Lee-Kevin/20.IoTRouter/images/5.png

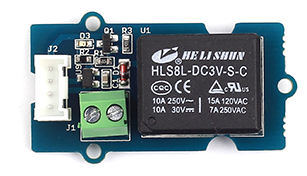
images/5.png
