Lee-Kevin/20.IoTRouter/images/6.png

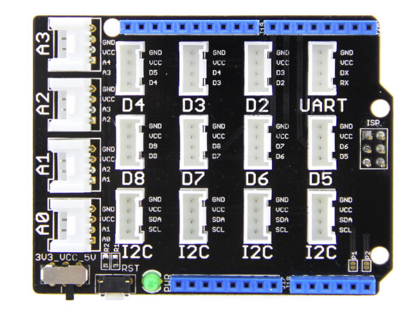
images/6.png
