Lee-Kevin/20.IoTRouter/images/8.png

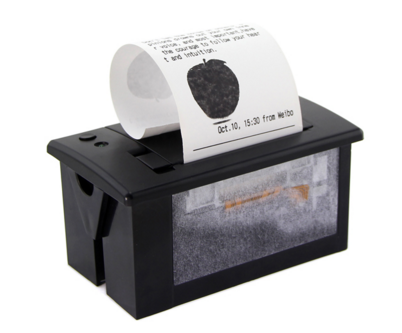
images/8.png
