Lee-Kevin/20.IoTRouter/images/13.png

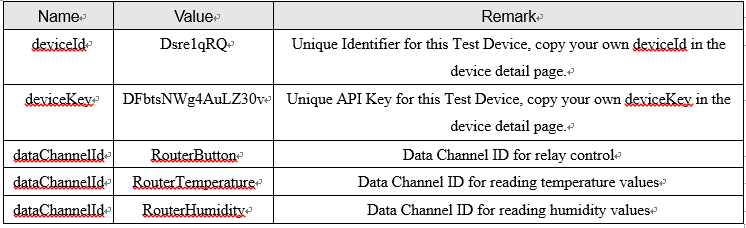
images/13.png
