Lee-Kevin/20.IoTRouter/images/15.png

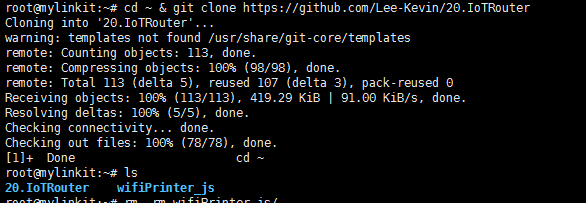
images/15.png
