Lee-Kevin/20.IoTRouter/images/17.png

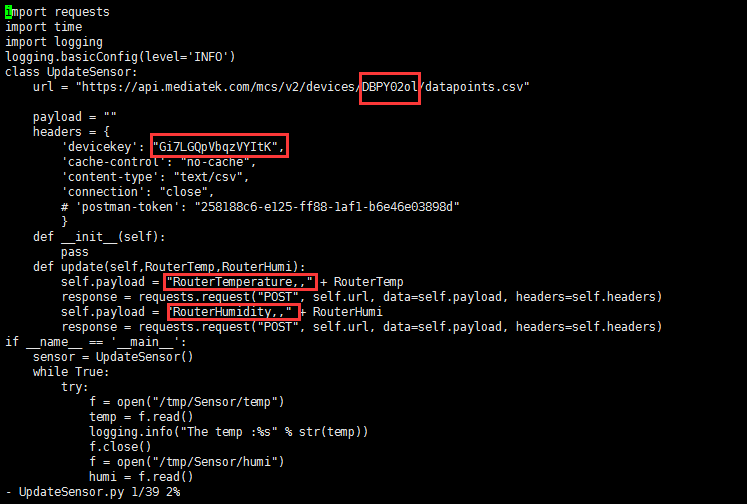
images/17.png
