Lee-Kevin/20.IoTRouter/images/18.png

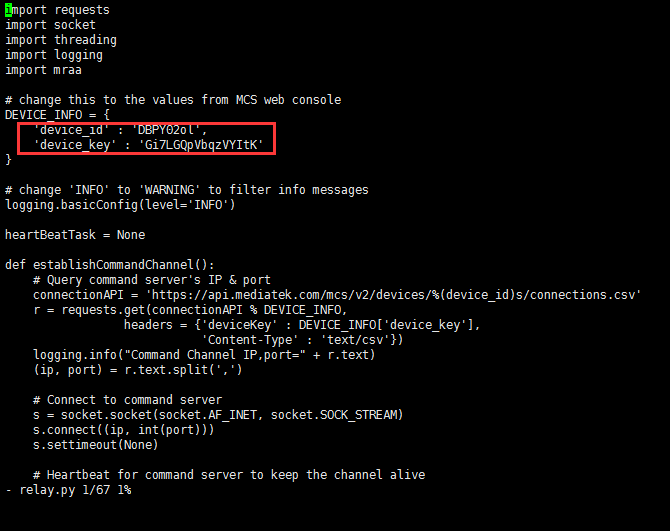
images/18.png
