Lee-Kevin/20.IoTRouter/images/21.jpg

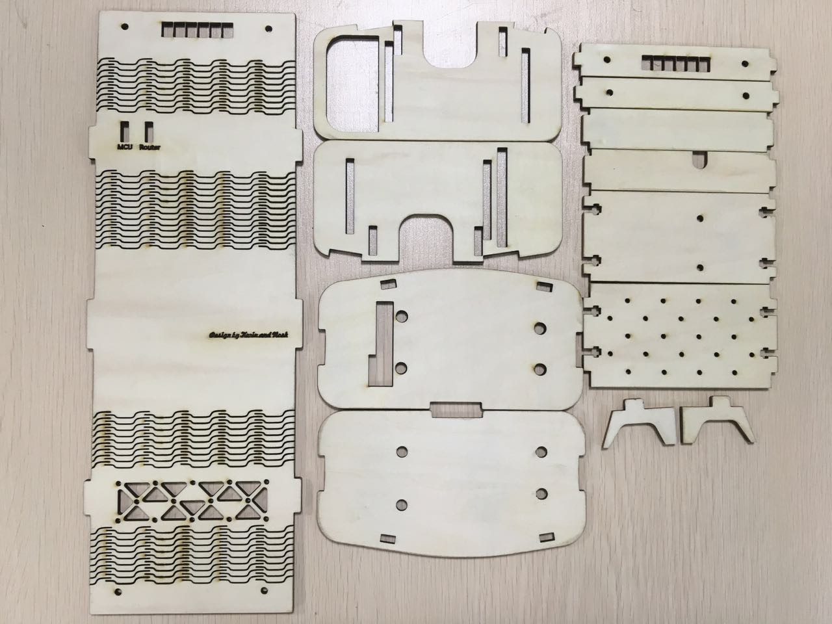
images/21.jpg
