Lee-Kevin/20.IoTRouter/images/22.png

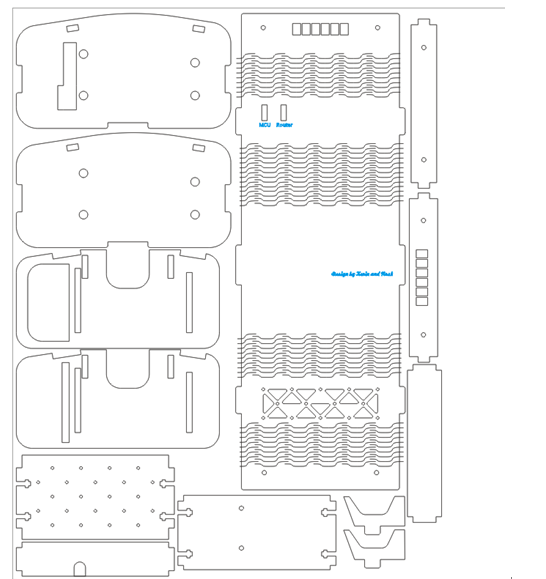
images/22.png
