Lee-Kevin/20.IoTRouter/images/23.png

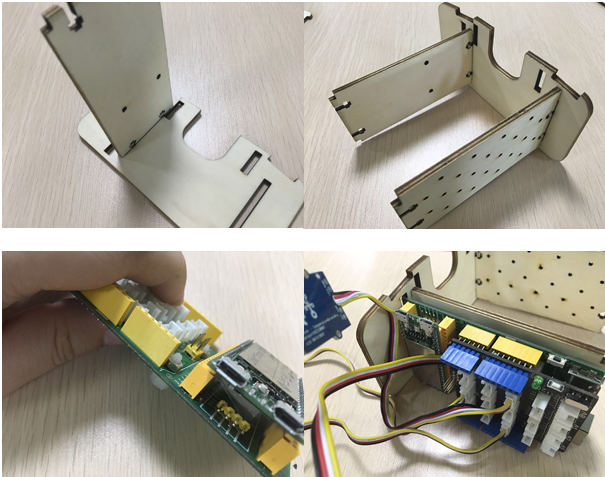
images/23.png
