Lee-Kevin/20.IoTRouter/images/24.png

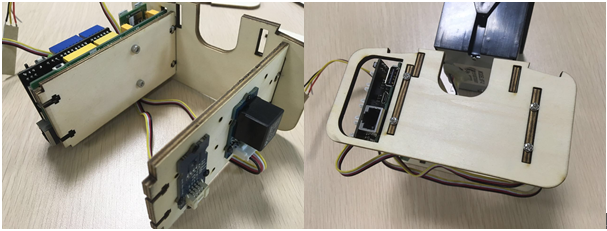
images/24.png
