Lee-Kevin/20.IoTRouter/images/25.jpg

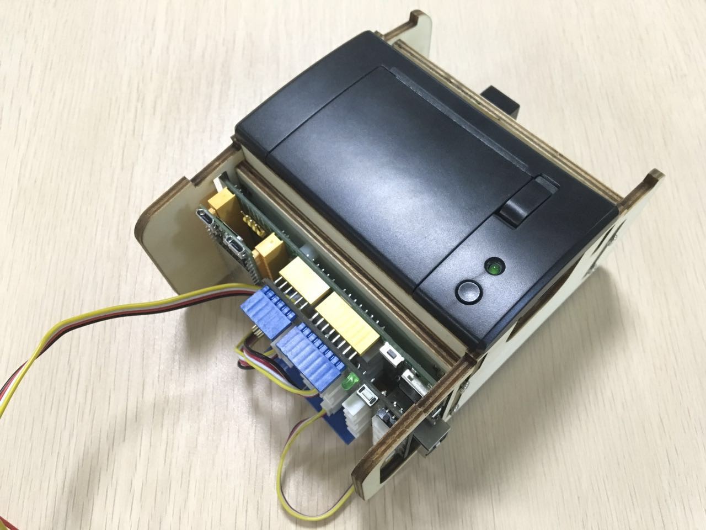
images/25.jpg
