Lee-Kevin/20.IoTRouter/images/26.png

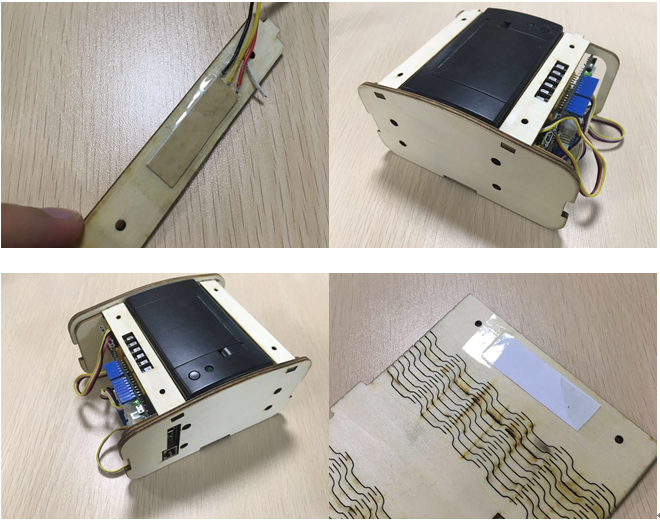
images/26.png
