Lee-Kevin/20.IoTRouter/images/27.png

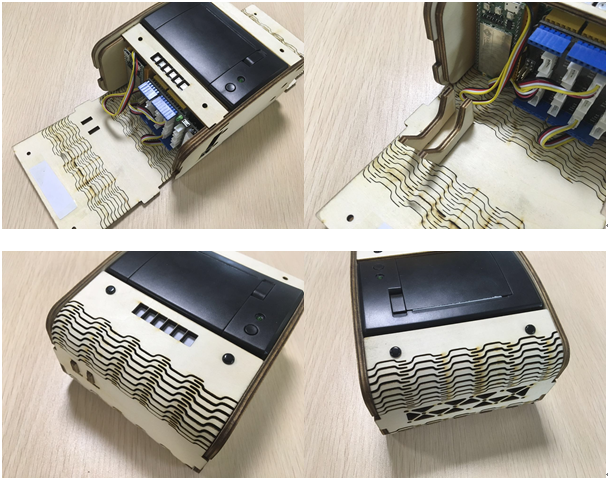
images/27.png
