Lee-Kevin/20.IoTRouter/images/28.jpg

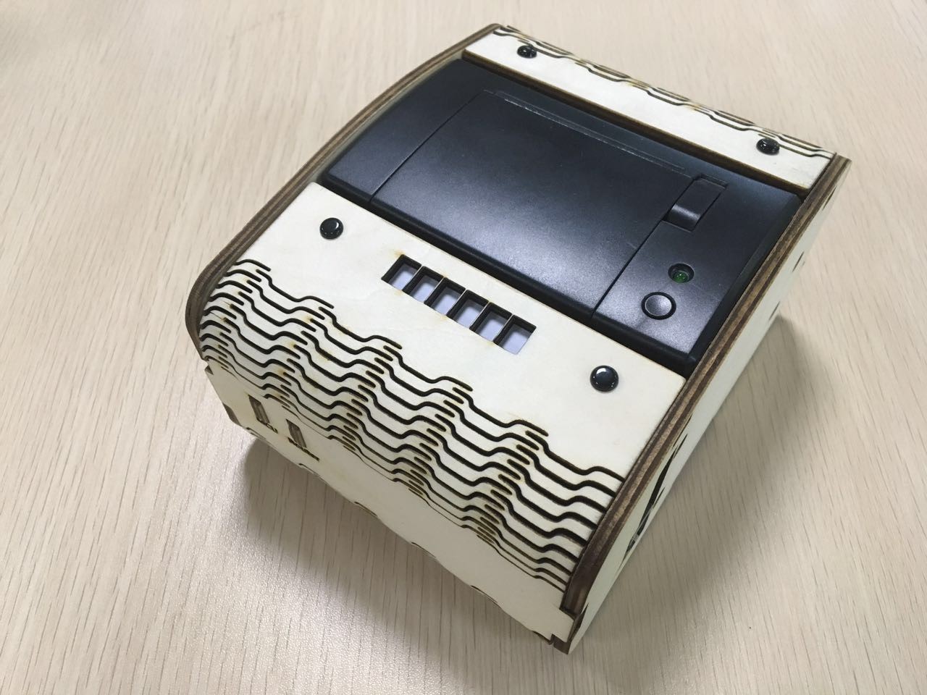
images/28.jpg
