Lee-Kevin/20.IoTRouter/images/29.jpg

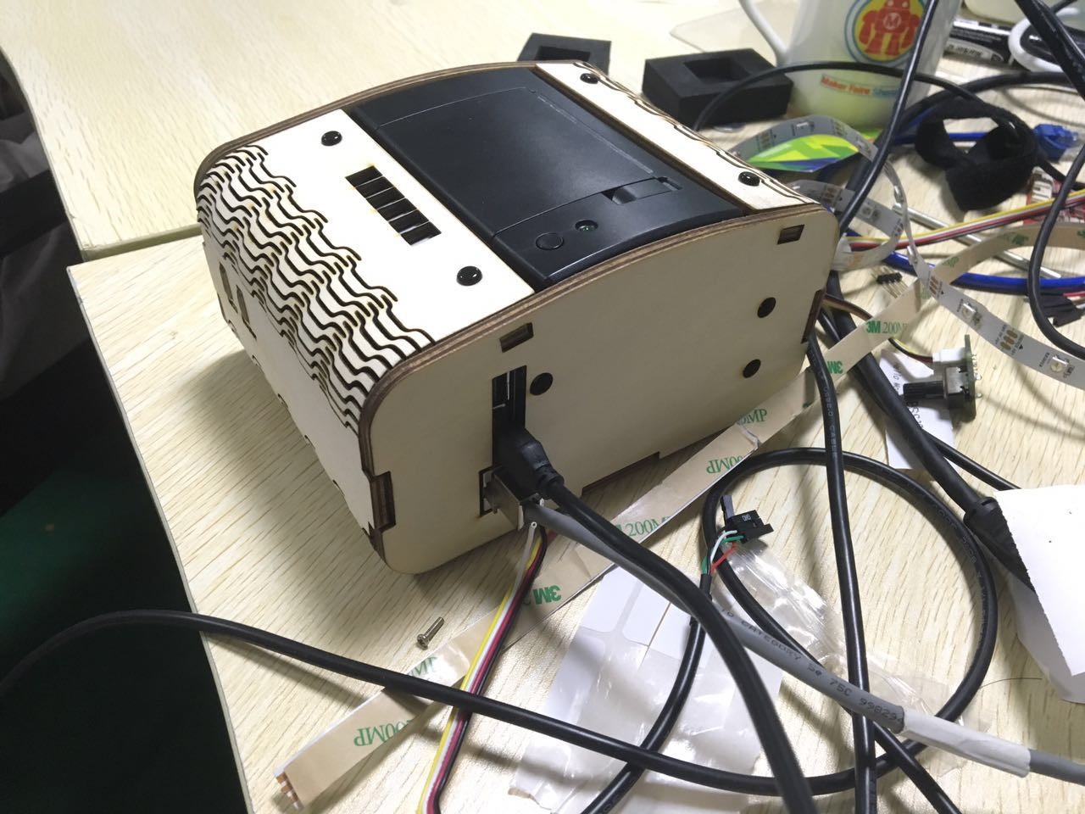
images/29.jpg
