Lee-Kevin/20.IoTRouter/images/31.jpg

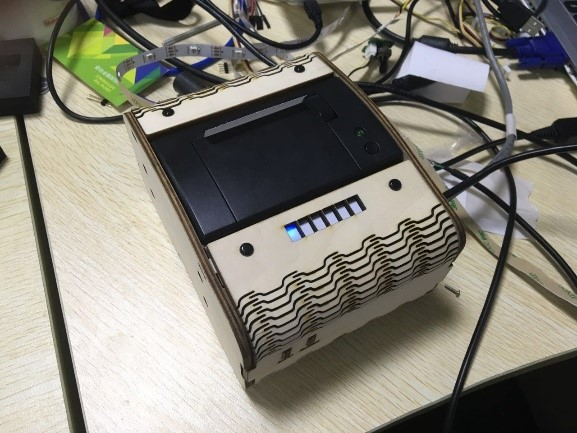
images/31.jpg
