Lee-Kevin/20.IoTRouter/images/32.png

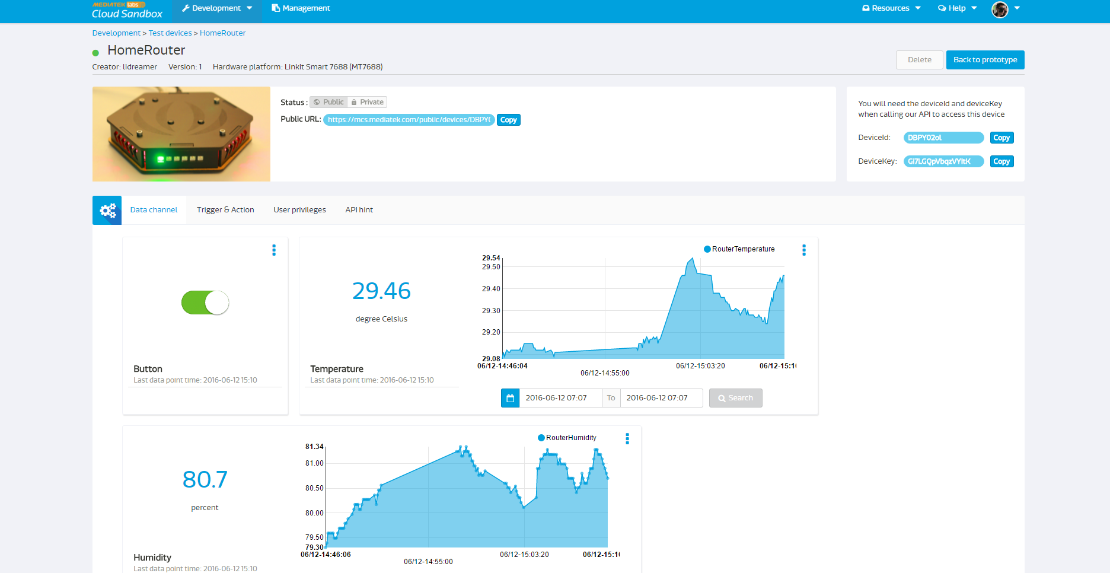
images/32.png
